nicholasteslaaa/translatingDevice/(commit log)

2025-12-31 Add Kokoro model and TTS code
    [translatorToken.csv, ttsToken.csv]
2026-01-17 update the image wiring
